LucasPifo/Sensor-magnetico-lowpower/(commit log)

2025-07-23 Correccion estado de acceso 0 abierto y 1 cerrado
2025-07-23 Se agrego antirrebote de 400 ms, asi como el retardo al obtener el valor del estado actual
2025-07-23 Se modifico el gitignore
2025-07-24 Se intercambio el estado del sensor
    Ahora el sensor envia el valor cerrado - 0 y abierto - 1
2025-07-24 Se intercambio el estado del sensor
