LucasPifo/Sensor-magnetico-lowpower/(notices)

Notices in the files:
README.md:
License: MIT
